Vlado-Perkovic/gonzales/(commit log)

2026-09-28 add gonzales
    [protoboard_enclosure.scad]
2026-09-28 add enclosure v2
    [protoboard_enclosure.scad]
2026-09-28 add continuous adc backend
    Runtime-selectable sampling backend (fw 0.3.1): oneshot busy-poll
    (~9 kHz) or continuous DMA paced at adcrate (10 kHz - 2 MHz, default
    500 kHz) with per-sample timestamps reconstructed from the frame pace.
    Same-mode set never deinits a live DMA driver (FreeRTOS assert); frames
    are drained before pulses and samples predating t0 are ignored.
    Also fixes NVS narrow-field loads spilling into adjacent cfg members
    (corrupted th10/adcrate) via rd_u8.
    Ultraworked with [Sisyphus](https://github.com/code-yeongyu/oh-my-openagent)
    [cfg.c, cfg.h, console.c, measure.c, measure.h]
2026-09-28 add analyze subcommand and mad stats
    analyze re-processes a saved results dir offline: stats table, summary
    and comb-annotated plots regenerated from samples.csv, so cam-fps/
    disp-hz can be applied or changed after gathering. MAD added to the
    stats (robust spread for heavy-tailed latency distributions); samples.csv
    is written before stats so artifacts survive a crash; Ctrl-C during run
    stops the device-side run. Smoke assertions updated for current help/cal
    error strings (11/11).
    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
    [gonzales.py, smoke_test.py]
2026-09-28 document 0.3 usage, backends and onset correction
    Full first-session transcript (mon/cal/oneshot/run/get), host-tool
    session with real output, self-tests, ADC backend comparison table,
    onset-correction derivation with worked example and validity notes.
    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
2026-09-28 widen enclosure front opening, mirror bottom hole
    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
    [protoboard_enclosure.scad]
